kakubus/ISB_Project/README.md

<hr/>
<h5>Politechnika Śląska</br>
Wydział Automatyki Elektroniki i Informatyki</br>
Automatyka i Robotyka Sem V (2020/2021). Grupa TI-4 (s. 5)</h5>
<hr/>
<h2>Inteligentny sterownik bramy - <i>Projekt na Systemy Mikroprocesorowe</i></h2>
<b>Autorzy:</b><br/>
<ul>
   <li><i>Jakub Kaniowski (https://github.com/kakubus)</i></li>
   <li><i>Szymon Ciemała (https://github.com/szymciem8)</i></li>
</ul>
<hr/>

<h4>Struktura repozytorium:</h4>

1. <b>main</b> - Główny program sterownika</i>
    * W tym miejscu znajdują się główne pliki dot. kodów źródłowych projektu - kod do ESP (*.ino).
2. <b>multiplexerTools</b> - Program obsługi multipleksera</i>
    * W tym miejscu znajdują się przydatne pliki do obsługi multipleksera. Może się przydać na przyszłość (*.ino).
3. <b>motorTools</b> - Prosty program sterowania L293D</i>
    * W tym miejscu znajdują się przydatne pliki do obsługi L293D. Może się przydać na przyszłość (*.ino).
4. <b>Documentation</b> - <i>folder plików</i>
    * W tym miejscu, znajduje się cała dokumentacja projektu. 
        * <b>Raport końcowy wymagany do prezentacji projektu na zajęciach.</b>
        * Dokumentacja związana z elementami stosowanymi w projekcie.
        * Inne pliki tymczasowe, schematy elektryczne, projekty płytek PCB.
6. <b>RFID</b> - <i>Program testowy dla modułu RFID</i>
 </br></br>   
 <hr/>
<p align="center">
   <p>Zaprojektowana i wytrawiona płytka PCB:<br/></p>
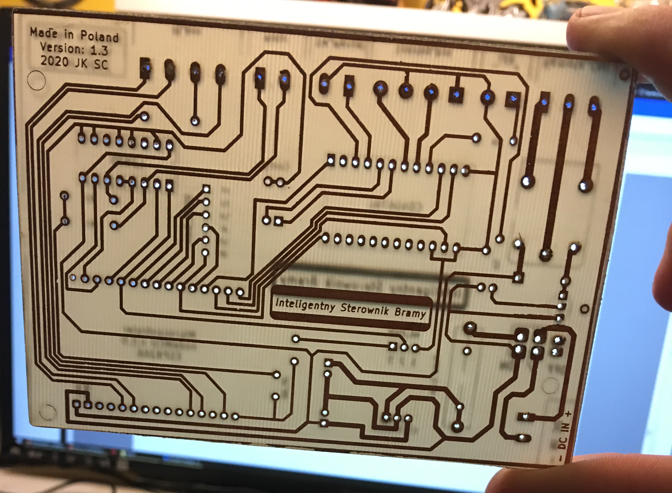
[picture p1: Inne/IMG_9818.JPG]
PCB
   
   <p>Skonstruowany sterownik:<br/></p>
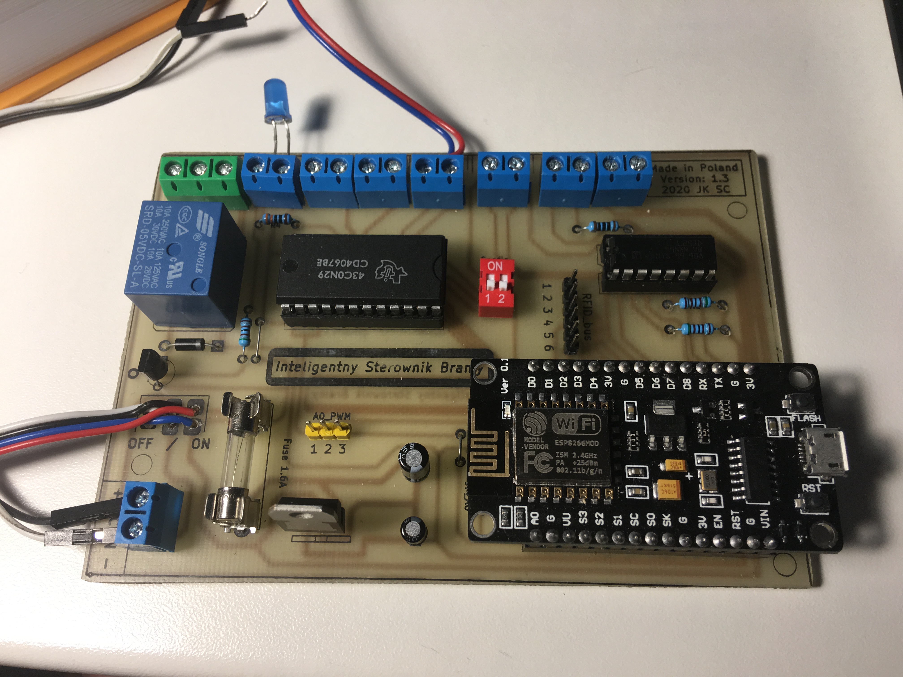
[picture p2: Inne/IMG_9850.JPG]
Sterownik bramy
   
   <p>Platforma testowa:<br/></p>
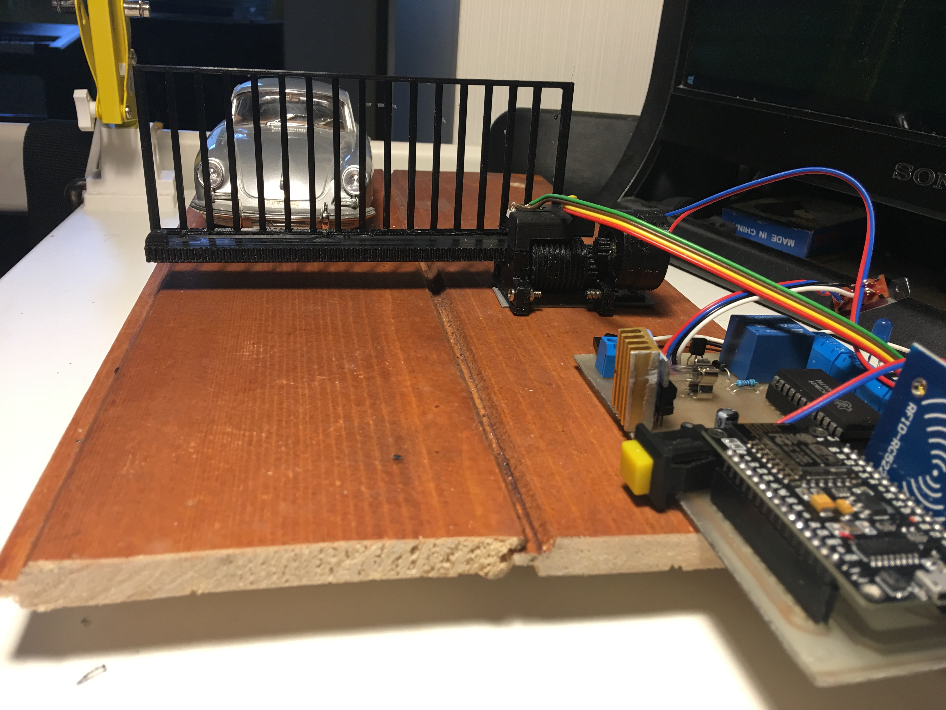
[picture p3: Inne/IMG_9793.JPG]
Platforma testowa
   
</p>
  <br/>
  <hr/>  
  <h6>Start projektu: Październik 2020 | Zakończenie: Grudzień 2020</h6>
  <hr/>
