kakubus/ISB_Project/Documentation/modelNapedu.png

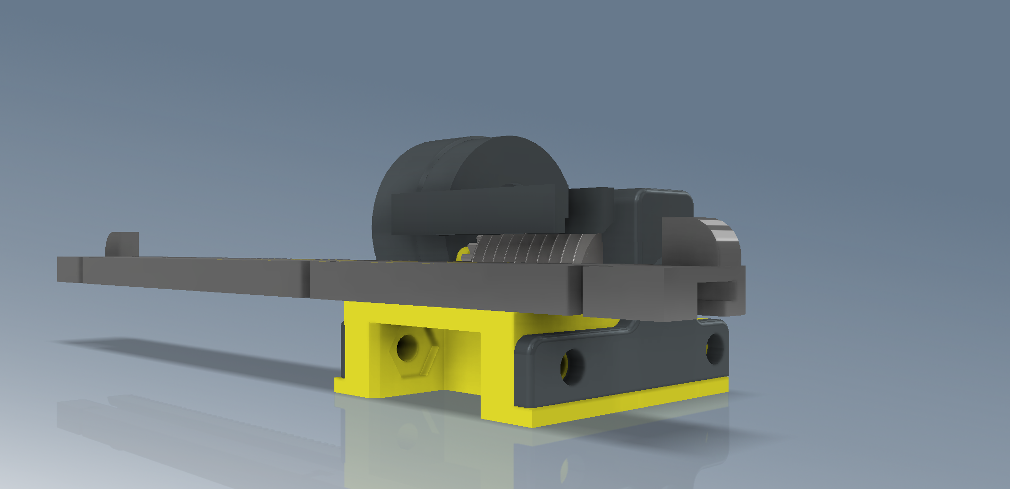
Documentation/modelNapedu.png
