kakubus/ISB_Project/Documentation/sterowanie przekaznikiem.png

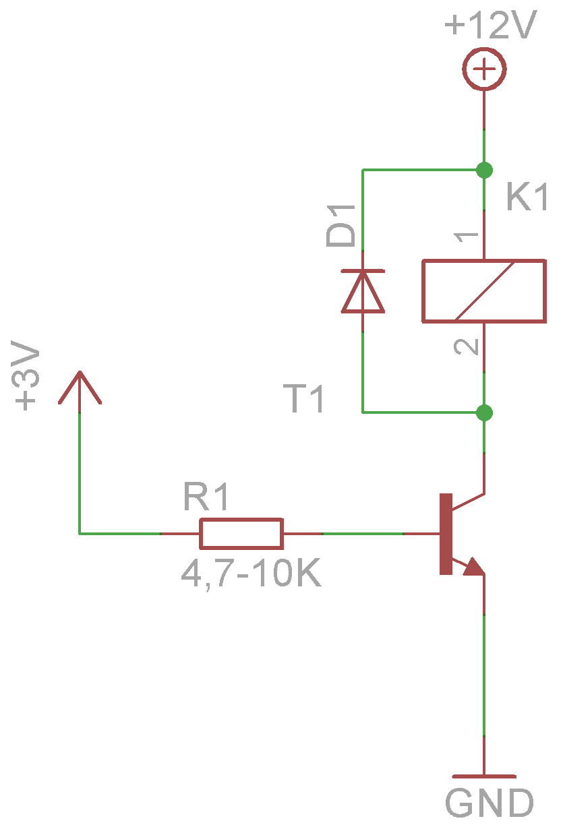
Documentation/sterowanie przekaznikiem.png
