kakubus/ISB_Project/Inne/IMG_9711.JPG

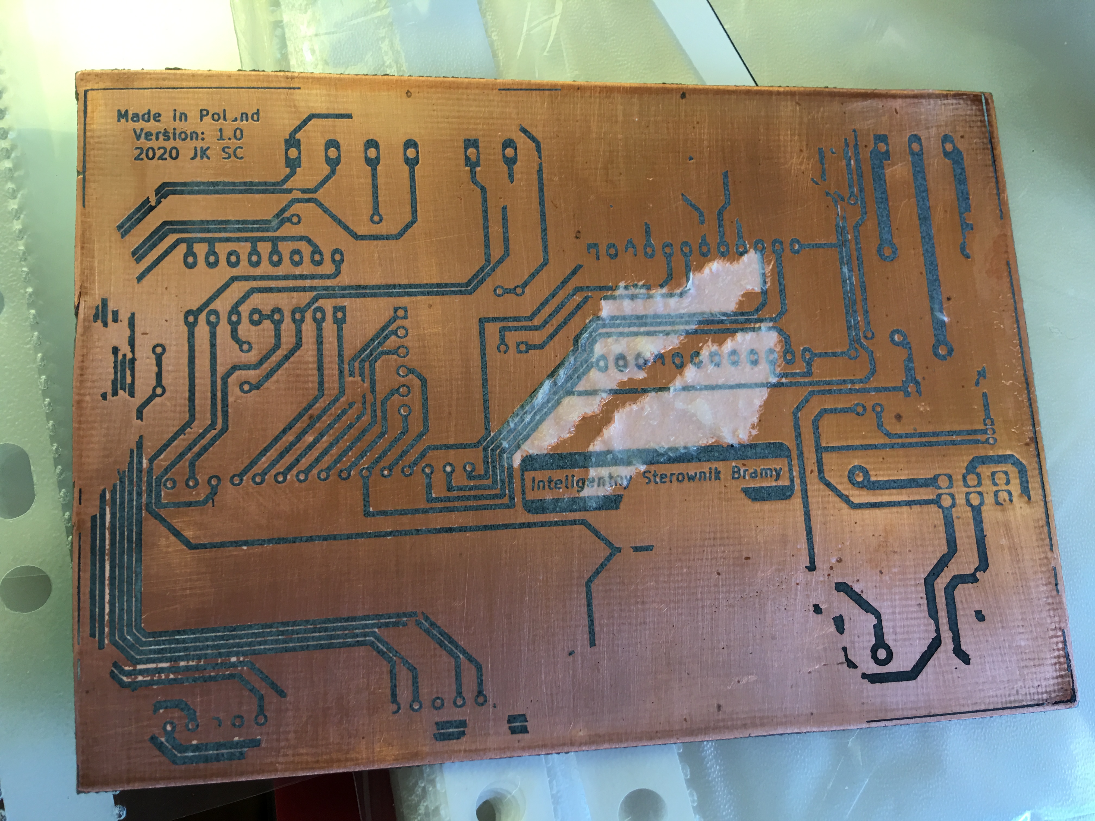
Inne/IMG_9711.JPG
