kakubus/ISB_Project/Inne/IMG_9712.JPG

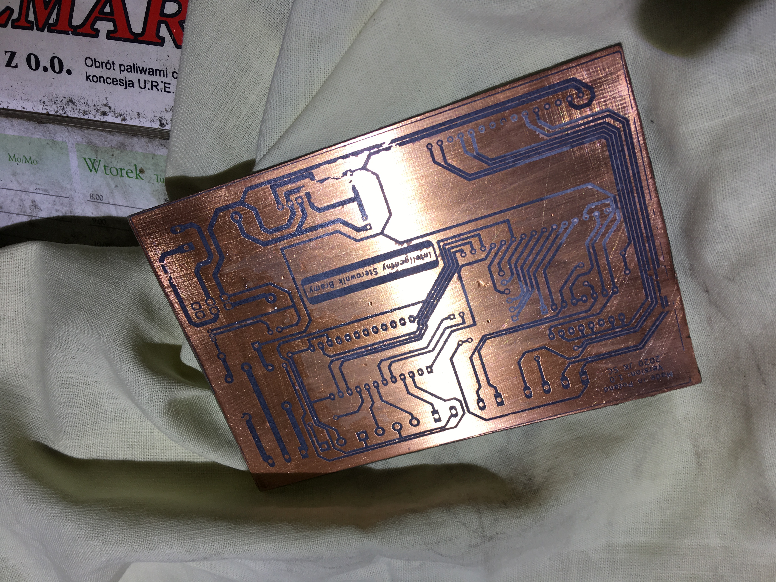
Inne/IMG_9712.JPG
