kakubus/ISB_Project/Inne/IMG_9717.JPG

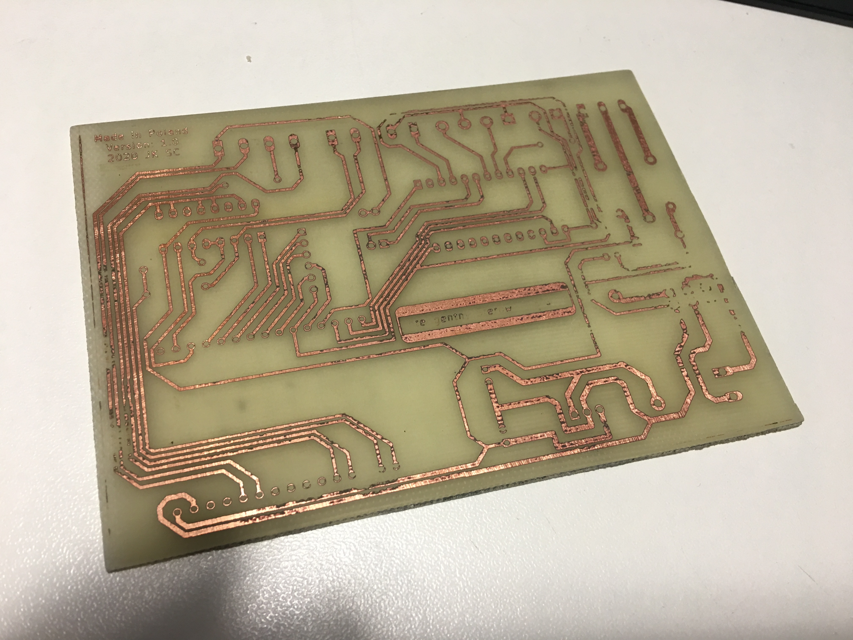
Inne/IMG_9717.JPG
