kakubus/ISB_Project/Inne/IMG_9733.JPG

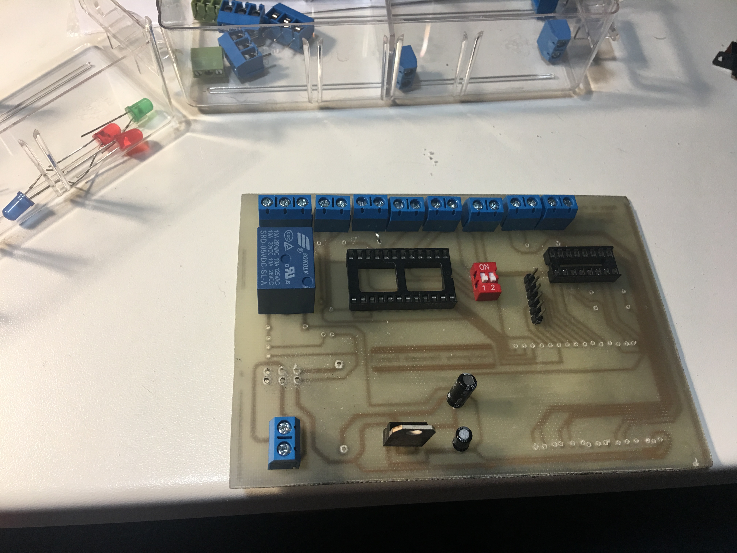
Inne/IMG_9733.JPG
