kakubus/ISB_Project/Inne/IMG_9734.JPG

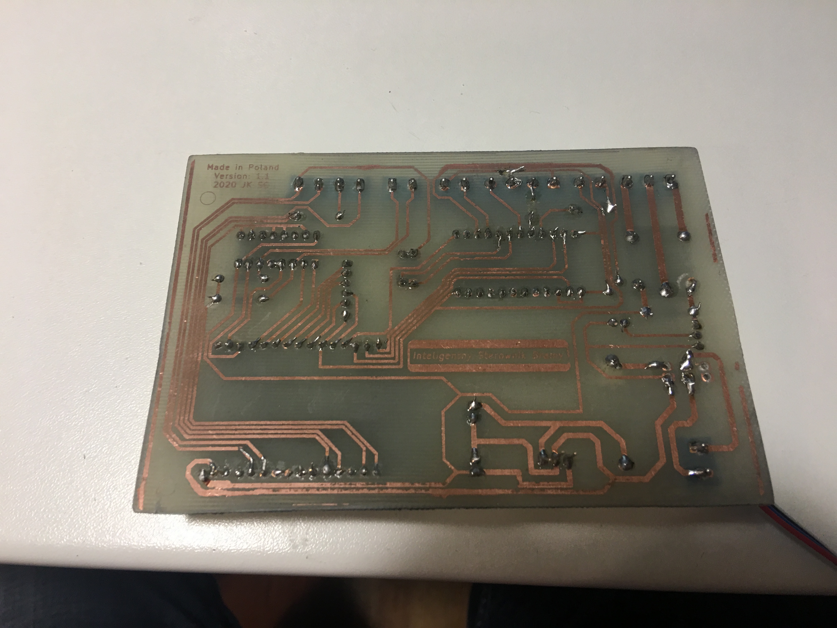
Inne/IMG_9734.JPG
