kakubus/ISB_Project/Inne/IMG_9735.JPG

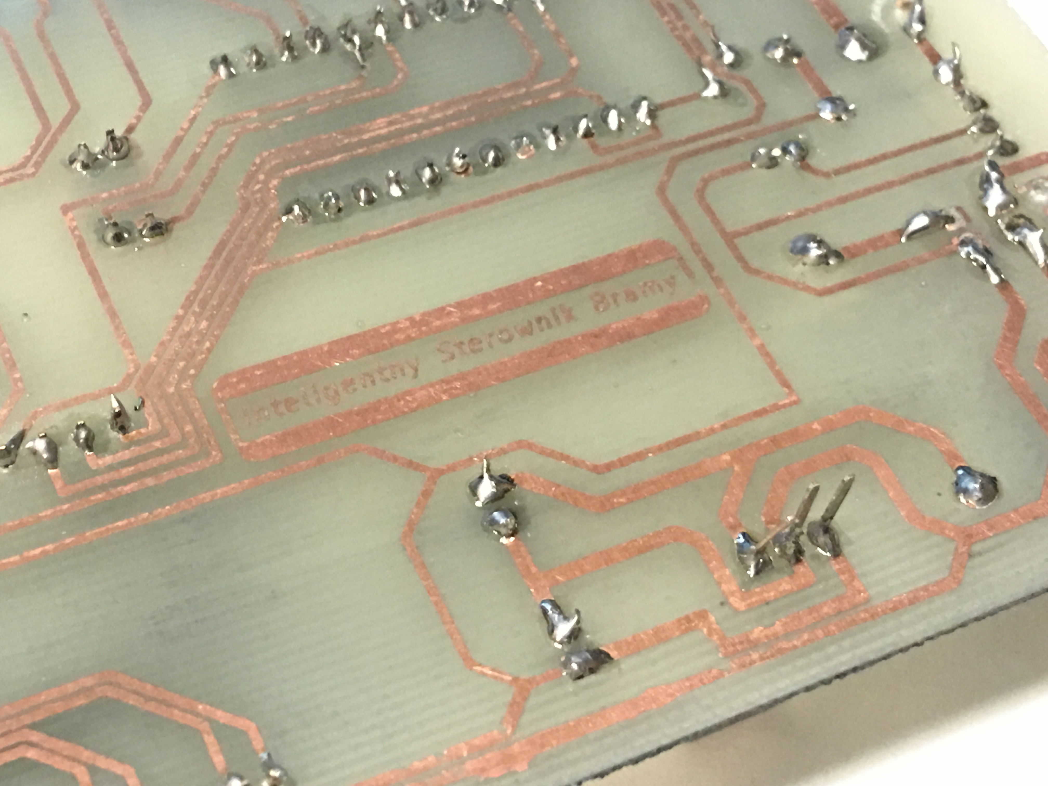
Inne/IMG_9735.JPG
