kakubus/ISB_Project/Inne/IMG_9736.JPG

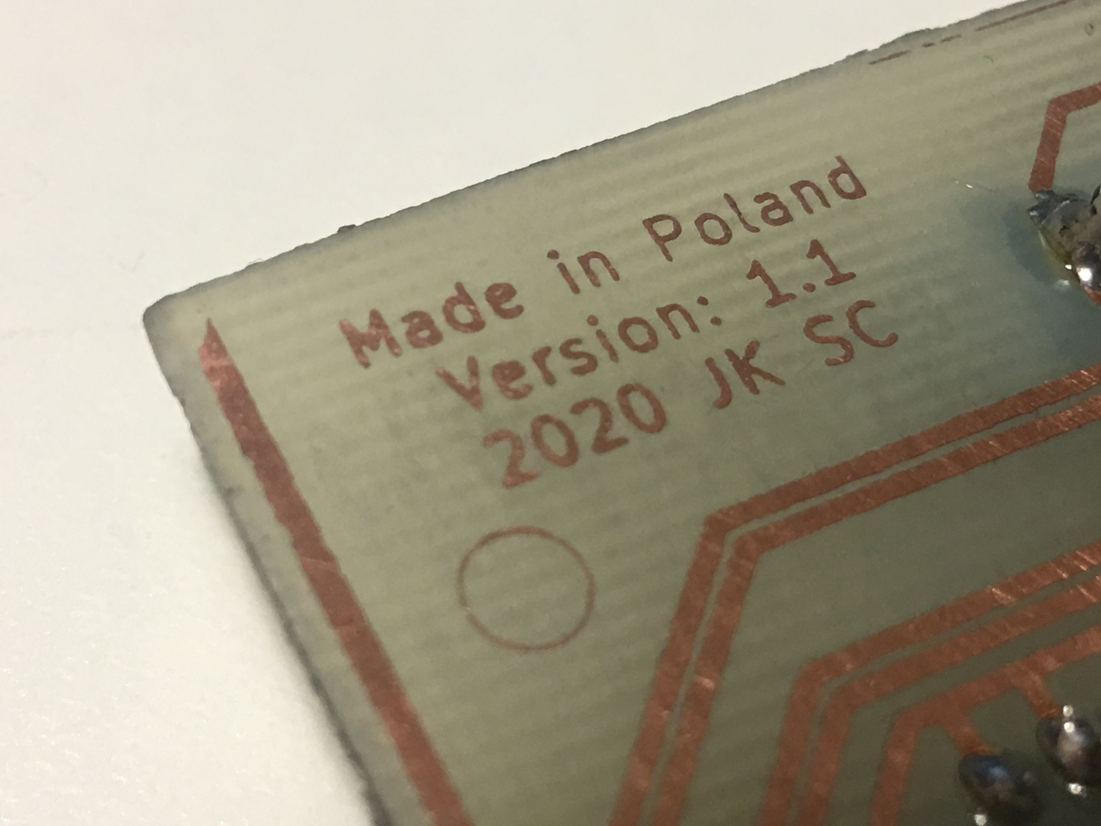
Inne/IMG_9736.JPG
