kakubus/ISB_Project/Inne/IMG_9737.JPG

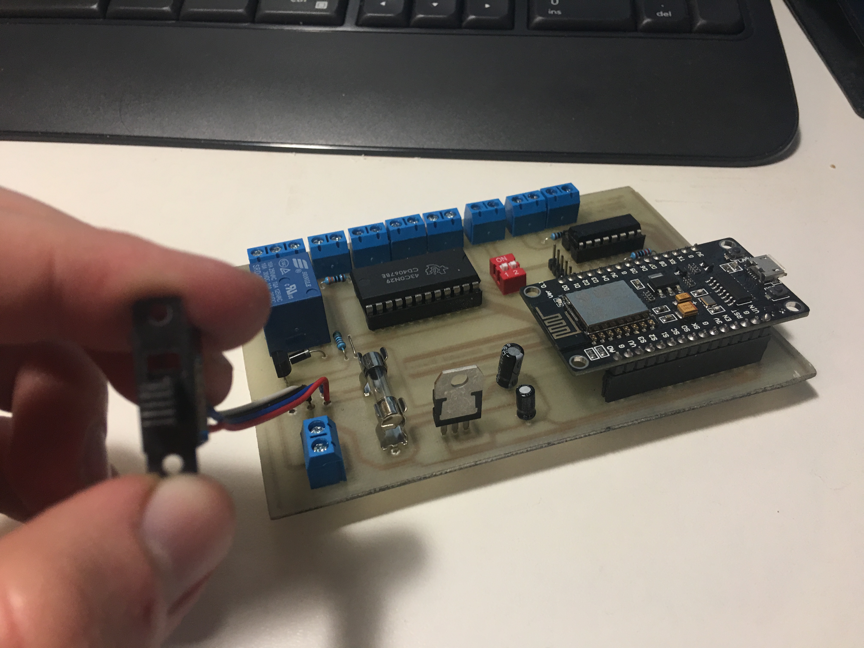
Inne/IMG_9737.JPG
