kakubus/ISB_Project/Inne/IMG_9738.JPG

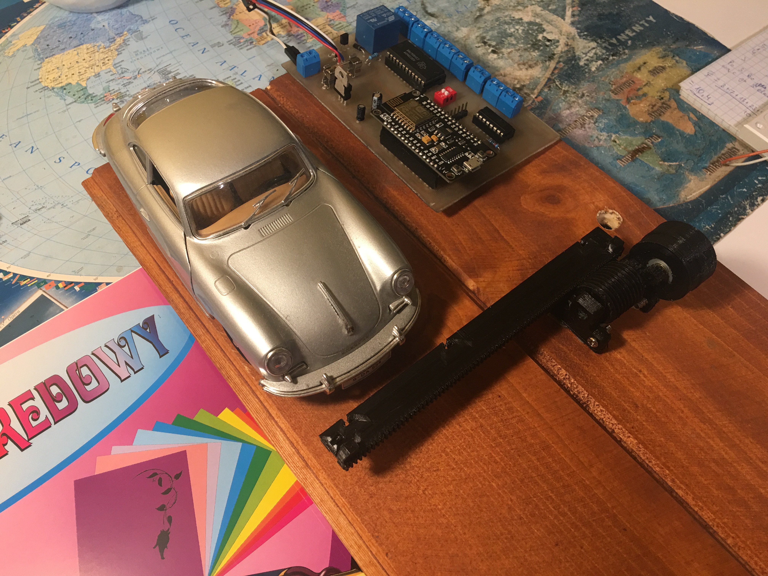
Inne/IMG_9738.JPG
