kakubus/ISB_Project/Inne/IMG_9743.JPG

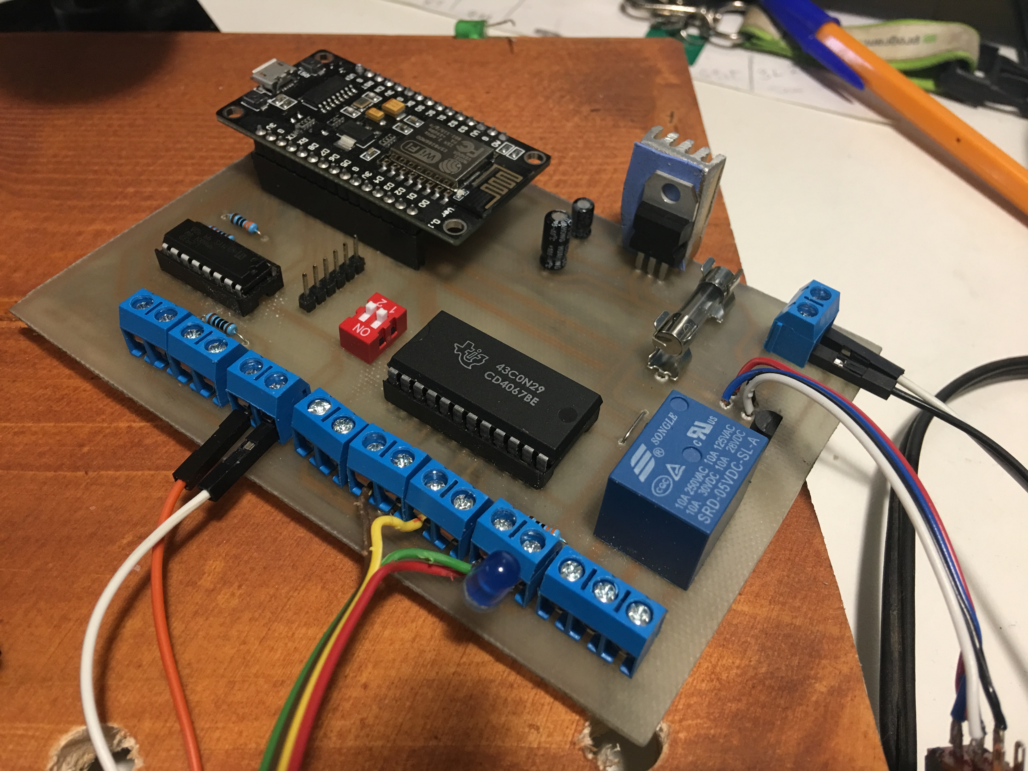
Inne/IMG_9743.JPG
