kakubus/ISB_Project/Inne/IMG_9752.JPG

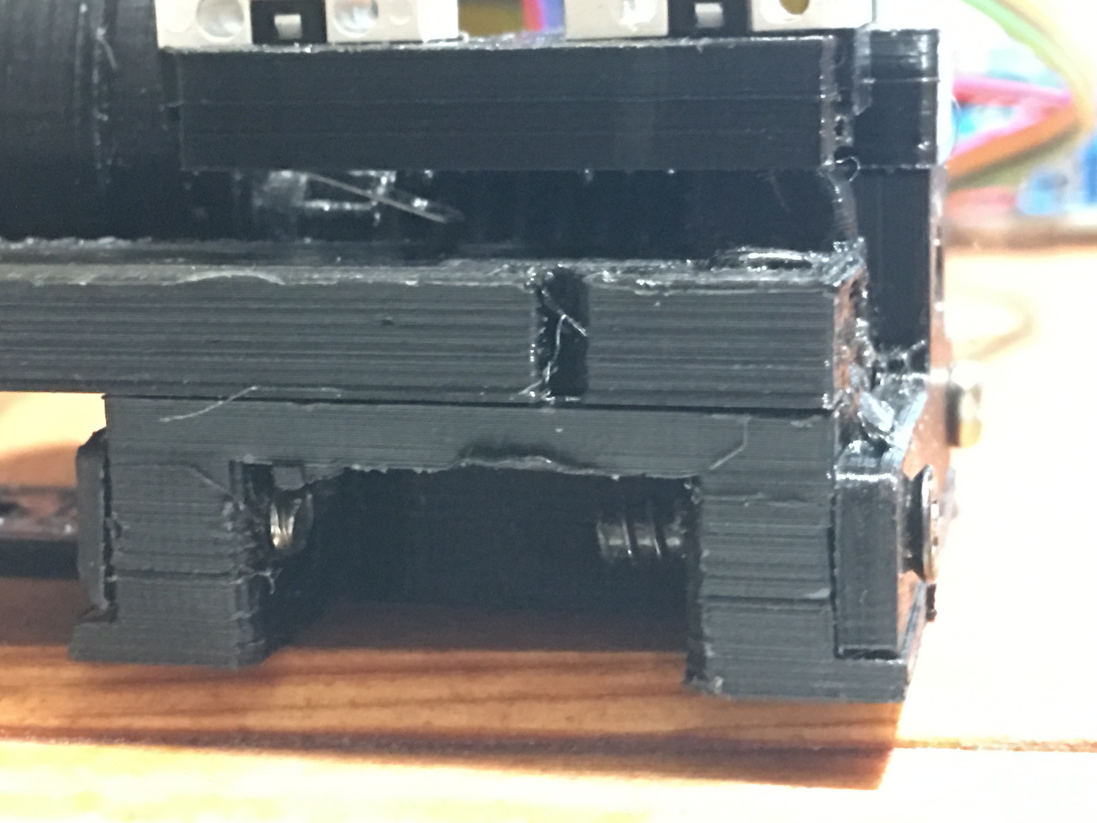
Inne/IMG_9752.JPG
