kakubus/ISB_Project/Inne/IMG_9763.JPG

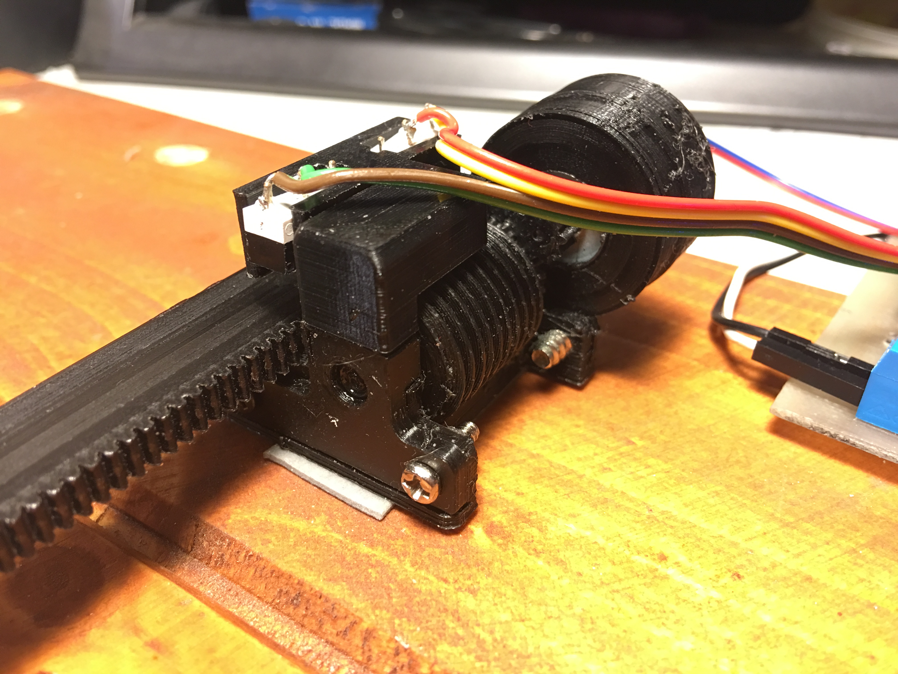
Inne/IMG_9763.JPG
