kakubus/ISB_Project/Inne/IMG_9764.JPG

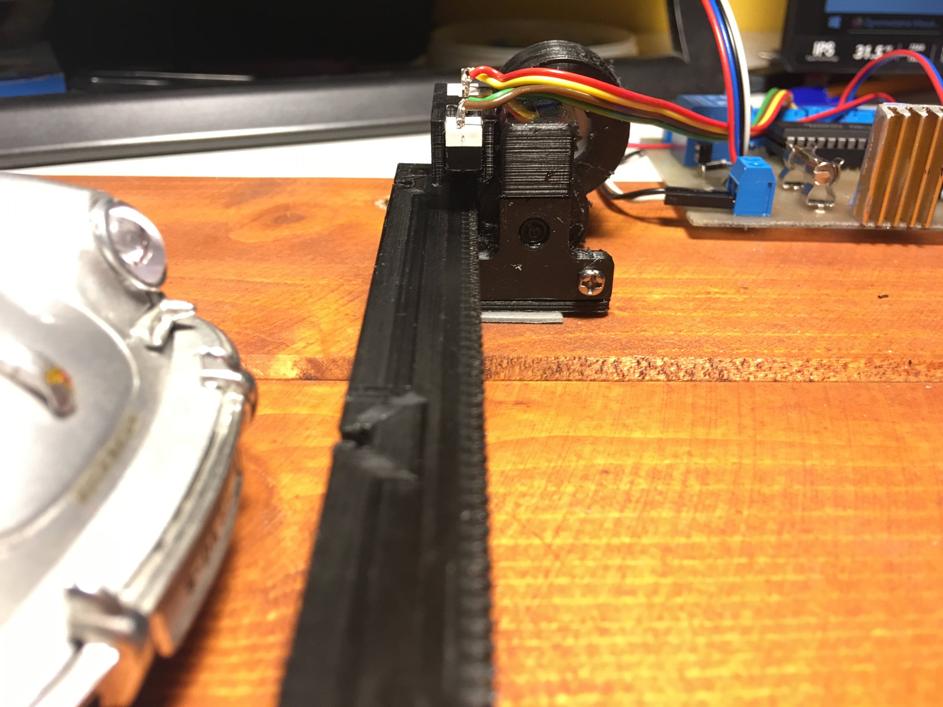
Inne/IMG_9764.JPG
