kakubus/ISB_Project/Inne/IMG_9765.JPG

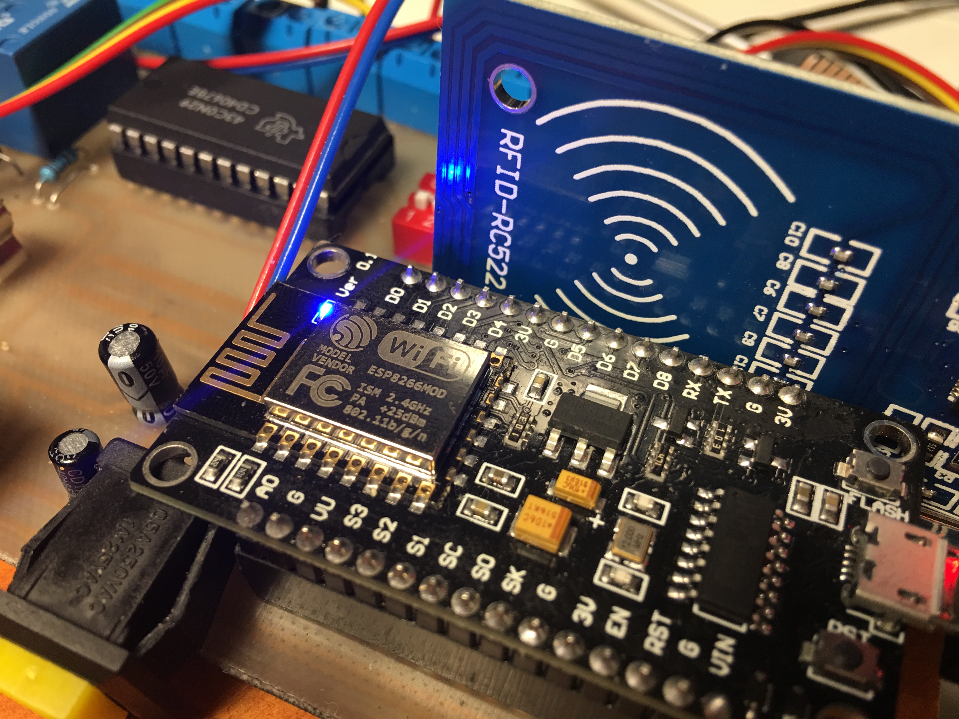
Inne/IMG_9765.JPG
