kakubus/ISB_Project/Inne/IMG_9766.JPG

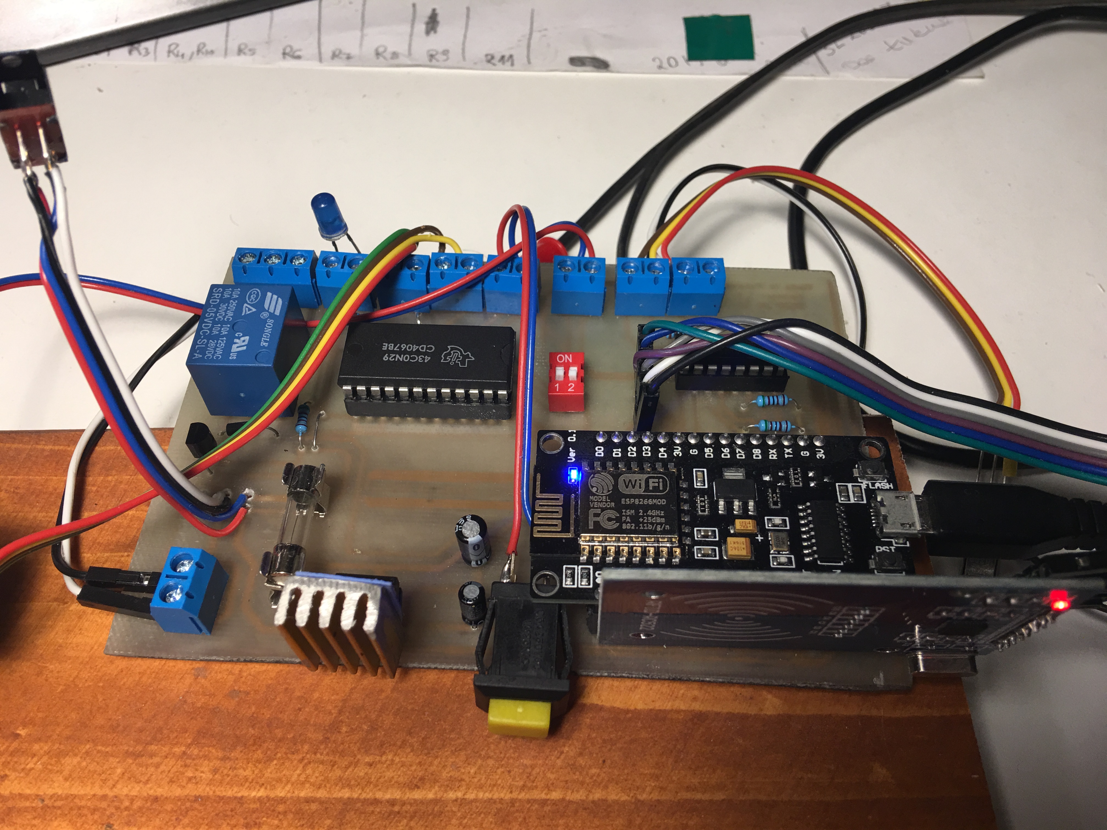
Inne/IMG_9766.JPG
