kakubus/ISB_Project/Inne/IMG_9768.JPG

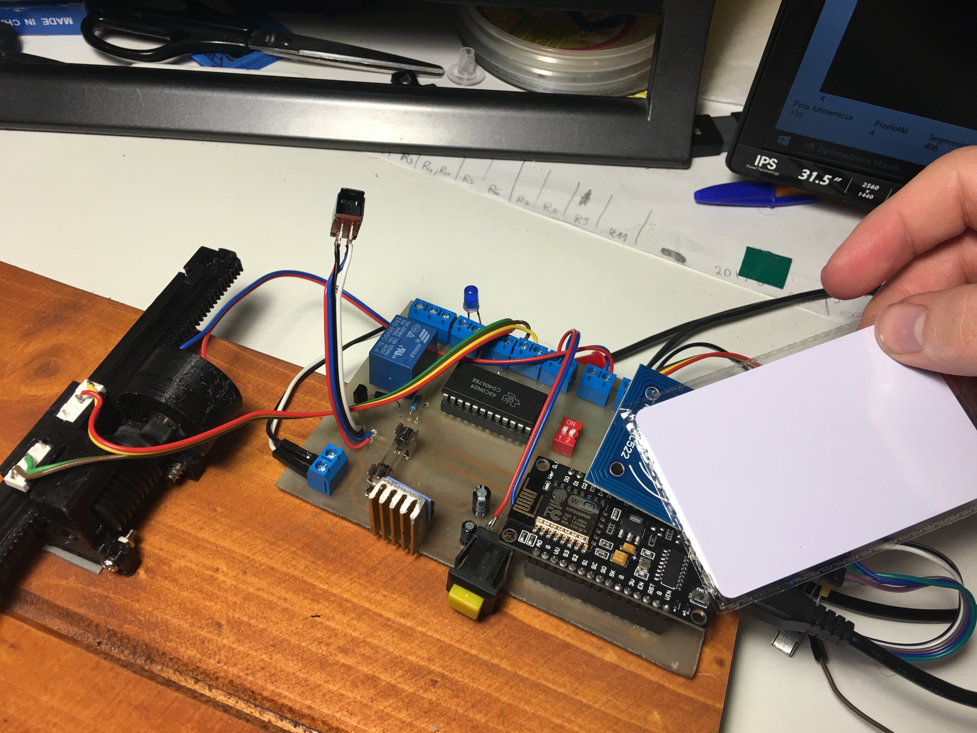
Inne/IMG_9768.JPG
