kakubus/ISB_Project/Inne/IMG_9770.JPG

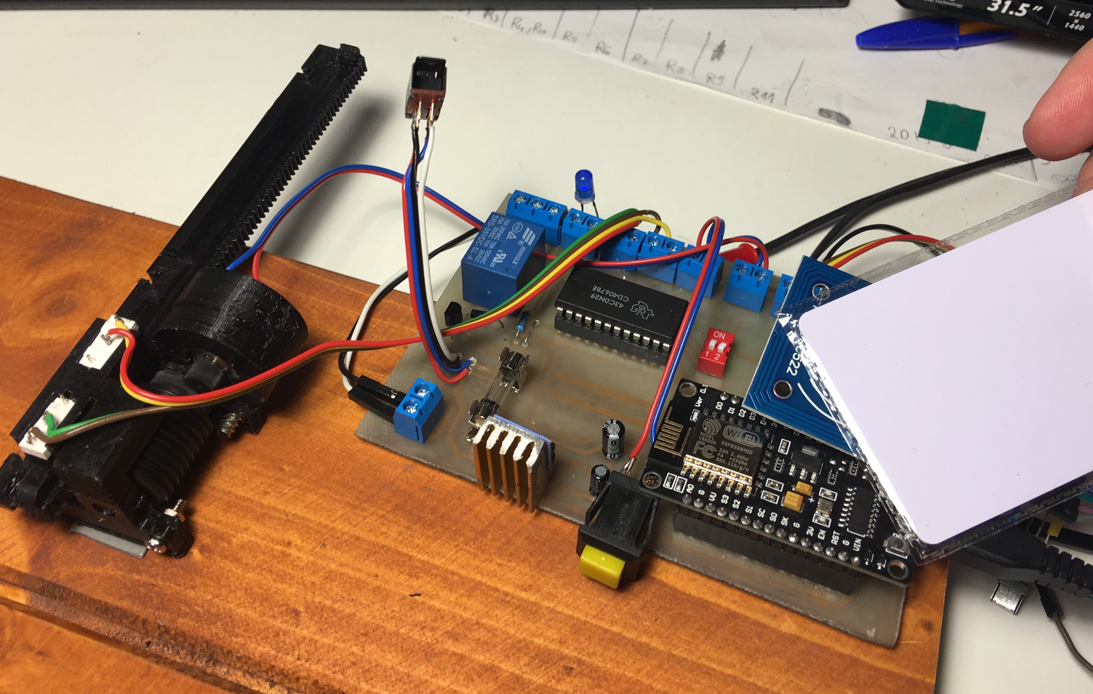
Inne/IMG_9770.JPG
