kakubus/ISB_Project/Inne/IMG_9774.JPG

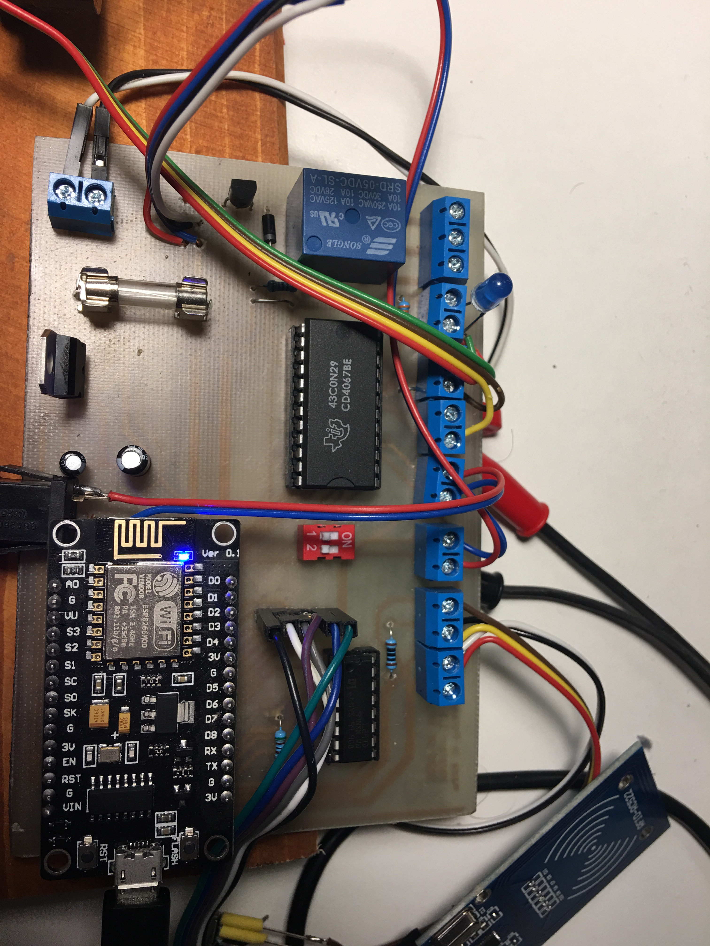
Inne/IMG_9774.JPG
