kakubus/ISB_Project/Inne/IMG_9775.PNG

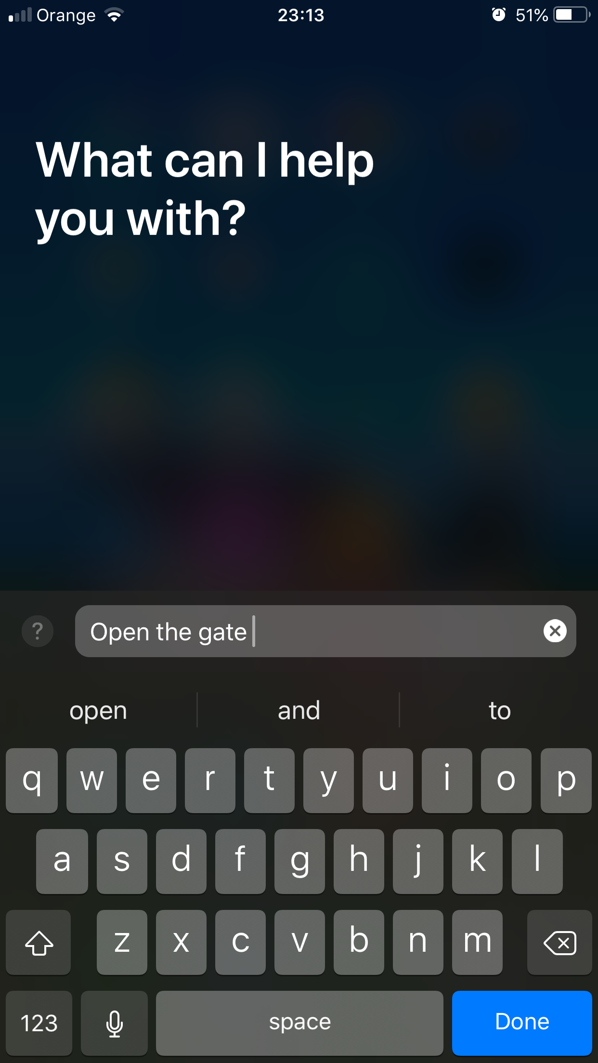
Inne/IMG_9775.PNG
