kakubus/ISB_Project/Inne/IMG_9777.JPG

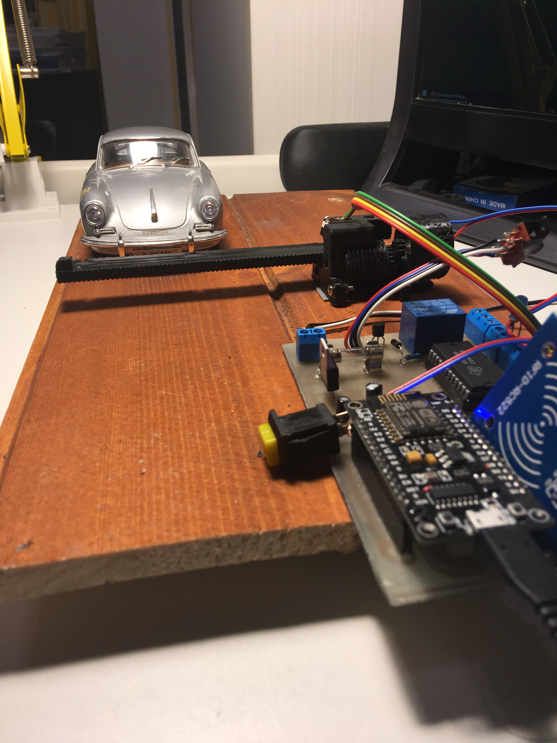
Inne/IMG_9777.JPG
