kakubus/ISB_Project/Inne/IMG_9778.PNG

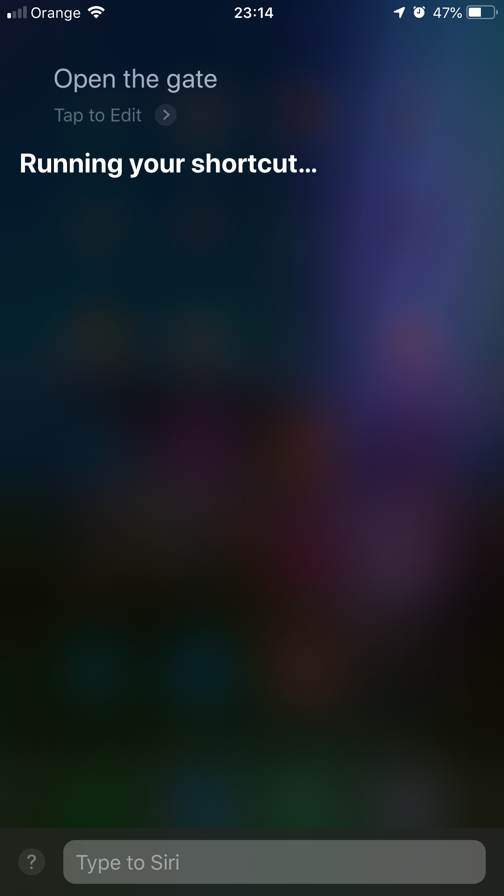
Inne/IMG_9778.PNG
