kakubus/ISB_Project/Inne/IMG_9780.JPG

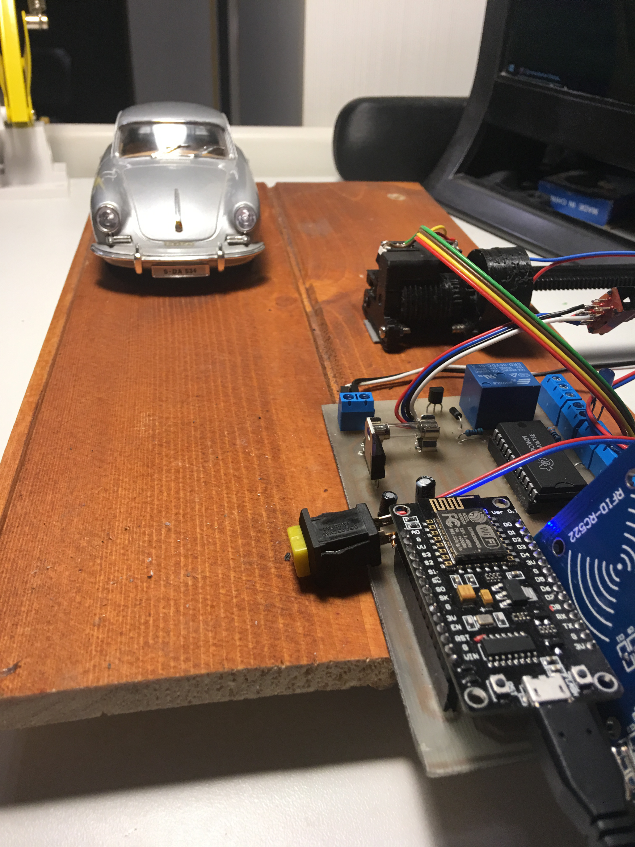
Inne/IMG_9780.JPG
