kakubus/ISB_Project/Inne/IMG_9782.PNG

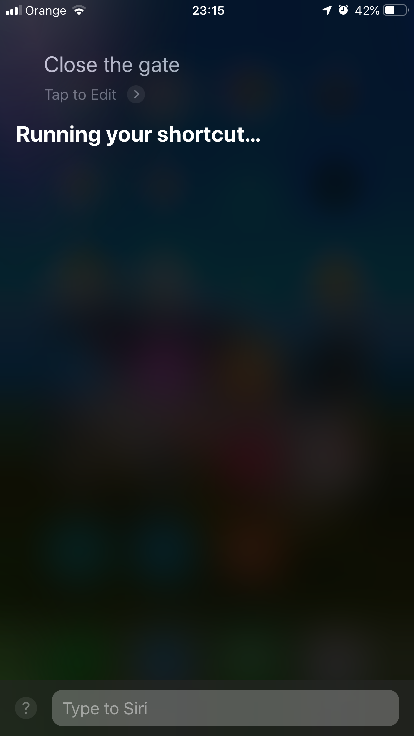
Inne/IMG_9782.PNG
