kakubus/ISB_Project/Inne/IMG_9783.JPG

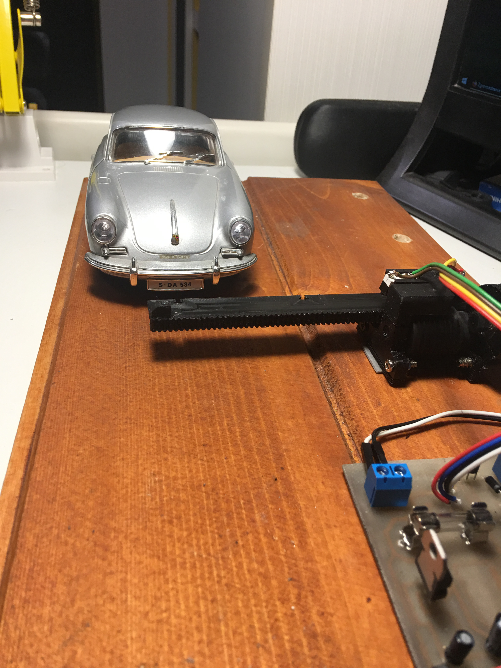
Inne/IMG_9783.JPG
