kakubus/ISB_Project/Inne/IMG_9790.JPG

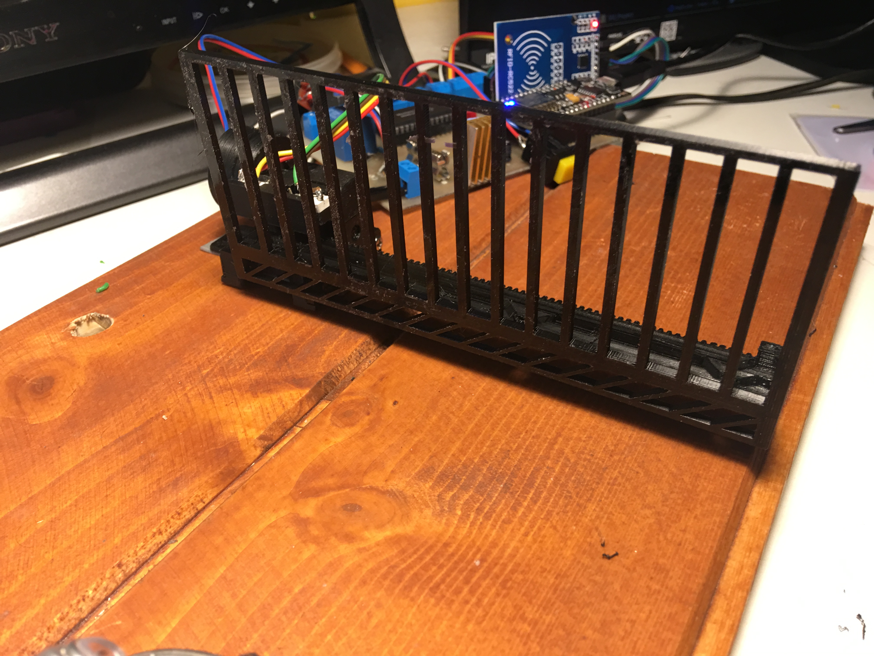
Inne/IMG_9790.JPG
