kakubus/ISB_Project/Inne/IMG_9791.JPG

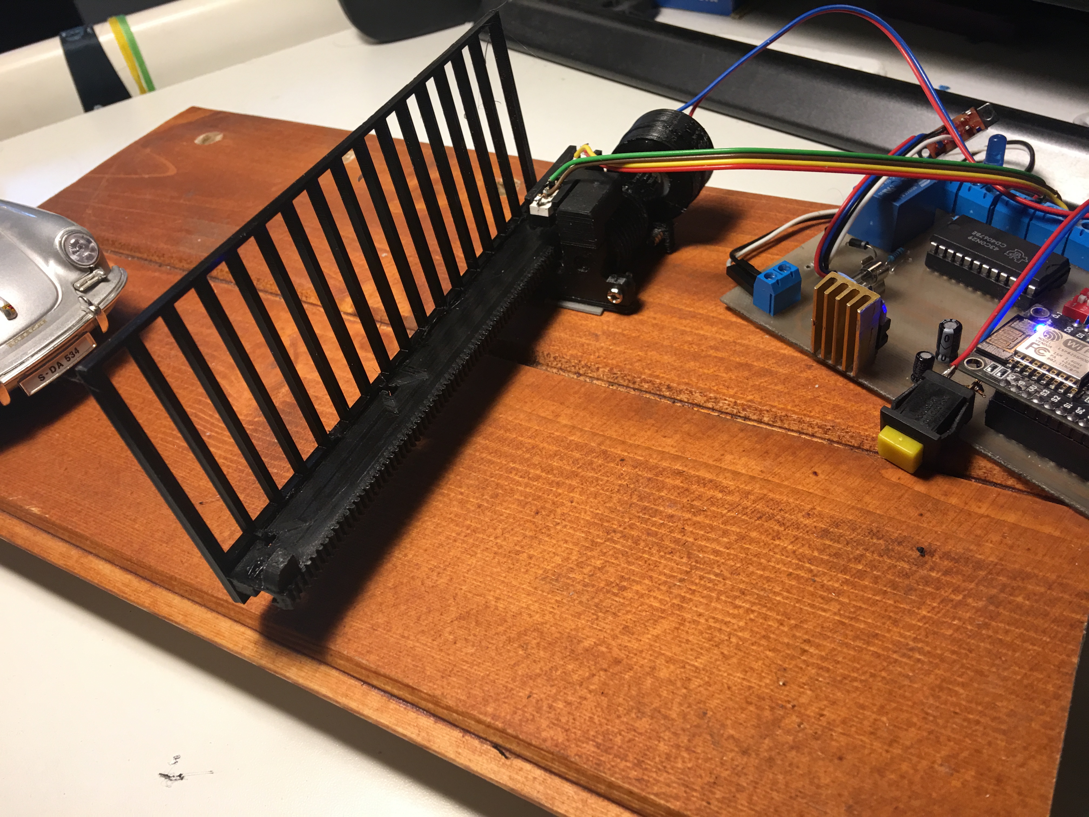
Inne/IMG_9791.JPG
