kakubus/ISB_Project/Inne/IMG_9792.JPG

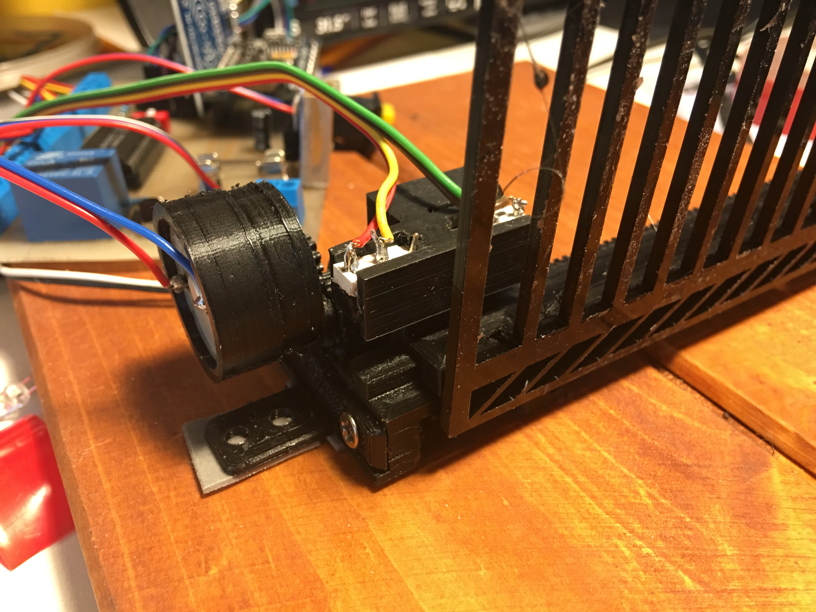
Inne/IMG_9792.JPG
