kakubus/ISB_Project/Inne/IMG_9794.JPG

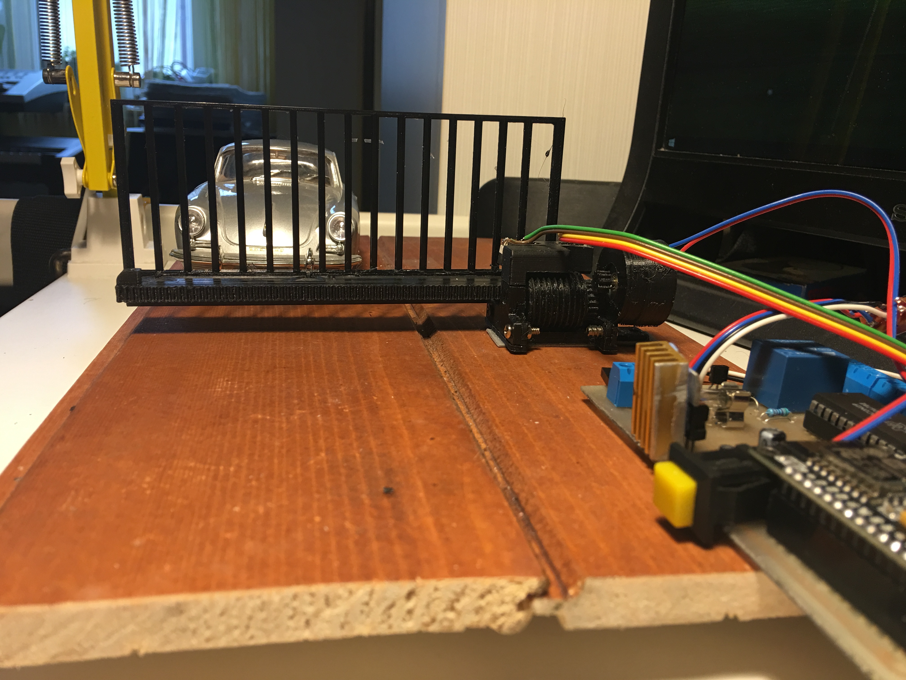
Inne/IMG_9794.JPG
