kakubus/ISB_Project/Inne/IMG_9840.JPG

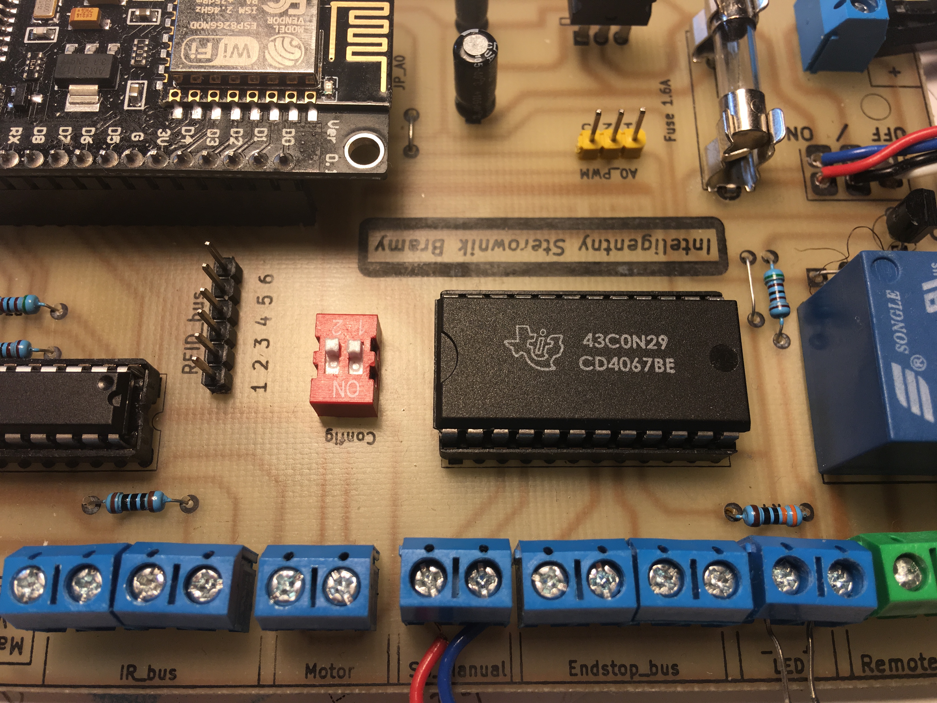
Inne/IMG_9840.JPG
