kakubus/ISB_Project/Inne/IMG_9841.JPG

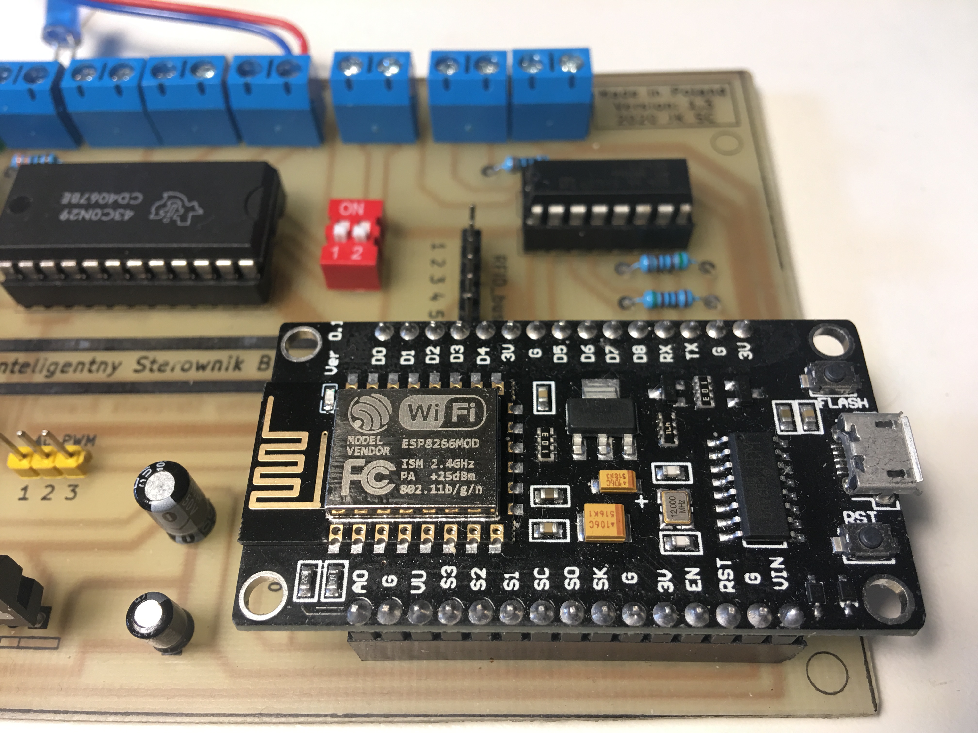
Inne/IMG_9841.JPG
