kakubus/ISB_Project/Inne/IMG_9849.jpg

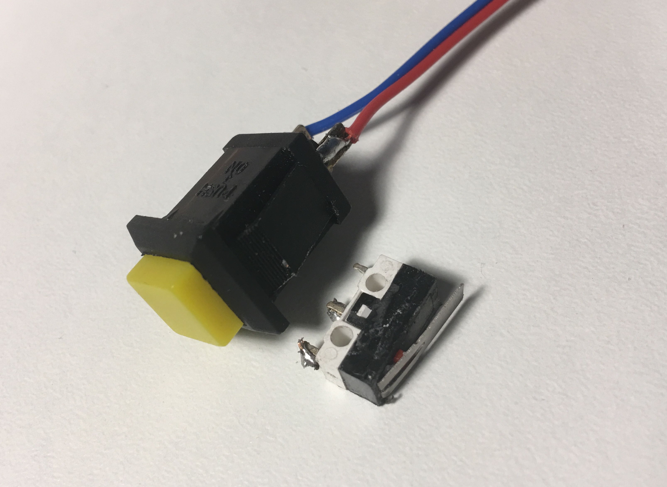
Inne/IMG_9849.jpg
