kakubus/ISB_Project/Documentation/Wykaz czesci.xlsx

Nazwa części | LINK | WIEDZA | PLNy
Sterownik Silnika L293D | https://botland.com.pl/pl/sterowniki-silnikow-dc/176-l293d-dwukanalowy-sterownik-silnikow-36v06a-5szt.html |  | 10 | 5
Odbiornik IR | https://botland.com.pl/pl/odbiorniki-podczerwieni/4931-odbiornik-podczerwieni-tsop31236-36-khz.html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 | https://forbot.pl/blog/kurs-elektroniki-ii-scalony-odbiornik-podczerwieni-tsop-id9641 | 3 | 1
Dioda IR | https://botland.com.pl/pl/diody-ir-podczerwone/282-nadajnik-ir-ope5594a-5mm-940nm.html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 |  |  | 1
Krańcówka | https://botland.com.pl/pl/przelaczniki-krancowe/17244-wylacznik-czujnik-krancowy-mini-5szt.html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
 | https://botland.com.pl/pl/czujniki-krancowe/10824-wylacznik-czujnik-krancowy-mini-z-dzwignia-wk611.html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 |  | 4
ESP8266 | https://botland.com.pl/pl/moduly-wifi/8241-modul-wifi-esp8266-nodemcu-v3.html?search_query=ESP8266&results=35 |  | 25 | 20
Diody LED | https://botland.com.pl/pl/diody-led/11440-dioda-led-5mm-czerwona-10szt.html?search_query=diody+LED&results=187 |  | 1.5
Przekaznik | https://botland.com.pl/pl/przekazniki-tradycyjne/4922-przekaznik-s3-5-cewka-5v-styki-10a240vac.html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 |  | 2
Elektro smieci R, C |  |  | 5
Bezpieczniki |  |  | 5
Silnik |  |  | 10
tactSwitch |  |  | 1.5
śrubki itp. |  |  | 5
RFID |  |  |  | 10
 |  |  | 72 | 37
