kakubus/ISB_Project/(list of files, drawings)

Other design files:
Documentation/PCB.pcb
