kakubus/ISB_Project/Documentation/PCB/Projekt/Projekt.kicad_pcb

## KiCad design Documentation/PCB/Projekt/Projekt.kicad_pcb (2022-06-17)

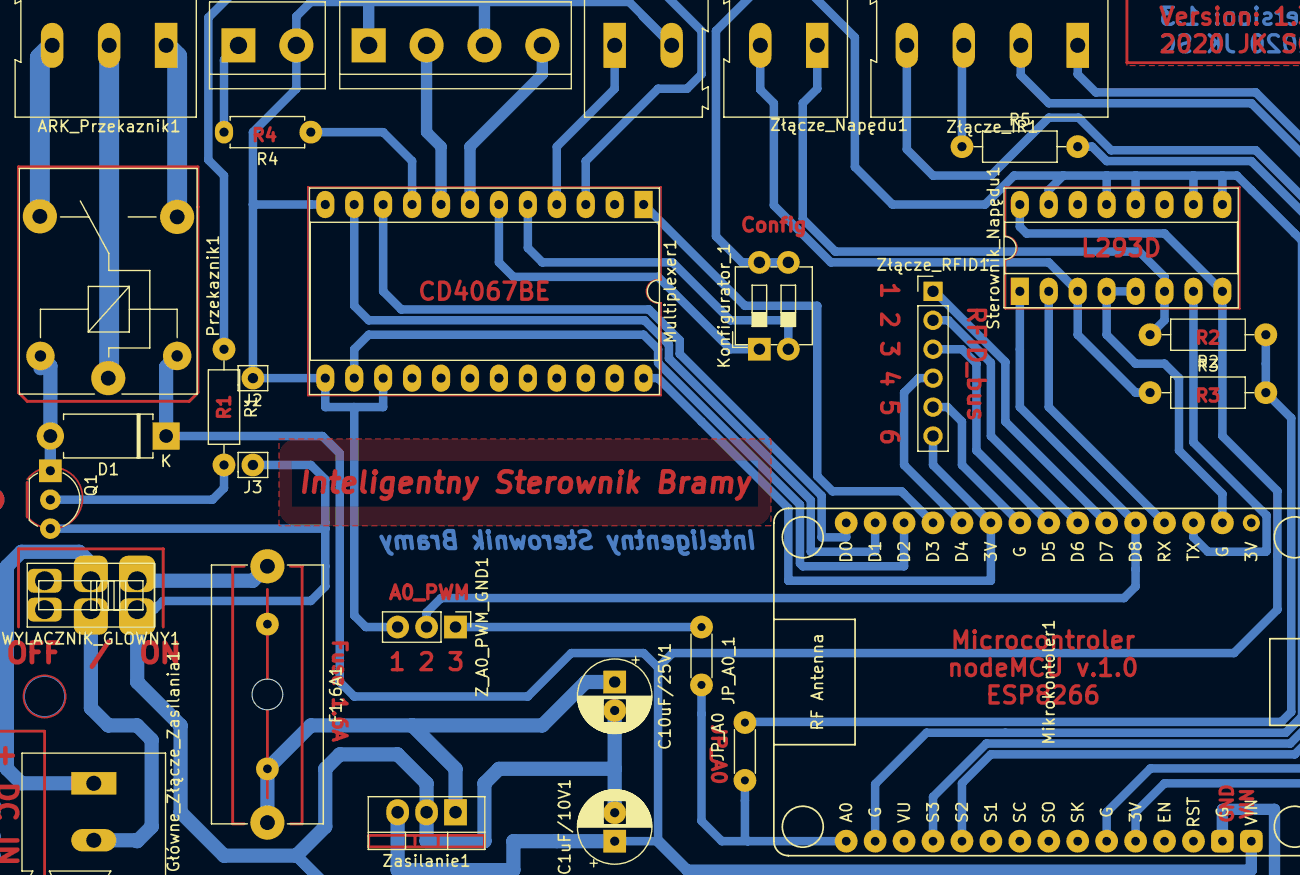
[picture p93: board Projekt.kicad_pcb from above]

Board: 2 copper layers, 30 parts (0 on the bottom side), 39 nets.

Parts:
ARK_Krancowki1: Conn_01x04_Female; TerminalBlock_bornier-4_P5.08mm
ARK_Powiad_LED1: Conn_01x02_Female; TerminalBlock_bornier-2_P5.08mm
ARK_Przekaznik1: Conn_01x03_Male; TerminalBlock_Altech_AK300-3_P5.00mm
C1uF/10V1, C10uF/25V1: CP1; CP_Radial_D6.3mm_P2.50mm
D1: D; D_DO-15_P10.16mm_Horizontal
F1,6A1: Fuse; MocownaieFuseholder_Cylinder-5x20mm_Schurter_0031_8201_Hori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
Główne_Złącze_Zasilania1: Conn_01x02_Female; TerminalBlock_Altech_AK300-2_P5.00mm
J2: Conn_01x01_Female; Pin_D0.9mm_L10.0mm_W2.4mm_FlatFork
J3: Conn_01x01_Male; Pin_D0.9mm_L10.0mm_W2.4mm_FlatFork
JP_A0, JP_A0_1: Jumper; R_Axial_DIN0204_L3.6mm_D1.6mm_P5.08mm_Horizontal
Konfigurator_1: SW_DIP_x02; SW_DIP_SPSTx02_Slide_6.7x6.64mm_W7.62mm_P2.54mm_LowProfile
Mikrokontoler1: NodeMCU1.0(ESP-12E); NodeMCU1.0(12-E)
Multiplexer1: CD4067BE; DIP-24_W15.24mm_Socket_LongPads
Przekaznik1: SANYOU_SRD_Form_C; Relay_SPDT_SANYOU_SRD_Series_Form_C
Q1: BC547; TO-92_Inline_Wide
R1: R5k; R_Axial_DIN0207_L6.3mm_D2.5mm_P10.16mm_Horizontal
R2: R220; R_Axial_DIN0207_L6.3mm_D2.5mm_P10.16mm_Horizontal
R3: R330; R_Axial_DIN0207_L6.3mm_D2.5mm_P10.16mm_Horizontal
R4: R330; R_Axial_DIN0207_L6.3mm_D2.5mm_P7.62mm_Horizontal
R5: R100; R_Axial_DIN0207_L6.3mm_D2.5mm_P10.16mm_Horizontal
Sterownik_Napędu1: L293D; DIP-16_W7.62mm_Socket_LongPads
WYLACZNIK_GLOWNY1: SW_DPST; SW_E_DPDT
Włącznik_Sterowania_Ręcznego1: SW_Push; TerminalBlock_Altech_AK300-2_P5.00mm
Z_A0_PWM_GND1: Zlacze_dev; PinHeader_1x03_P2.54mm_Vertical
Zasilanie1: LM7805_TO220; TO-220-3_Vertical
Złącze_IR1: 01; TerminalBlock_Altech_AK300-4_P5.00mm
Złącze_Napędu1: Conn_01x02_Female; TerminalBlock_Altech_AK300-2_P5.00mm
Złącze_RFID1: Conn_01x06_Female; PinHeader_1x06_P2.54mm_Vertical

Connections:
+12V: Główne_Złącze_Zasilania1.1, WYLACZNIK_GLOWNY1.3
/+3V: Mikrokontoler1.16, Mikrokontoler1.25, Multiplexer1.24, Złącze_RFID1.6
/+5V: C1uF/10V1.1, D1.1, Mikrokontoler1.15, Przekaznik1.2, Sterownik_Napędu1.8, Sterownik_Napędu1.16, Zasilanie1.3
/A0: JP_A0.1, JP_A0.2, JP_A0_1.2, Mikrokontoler1.1, R2.1, R3.2
/IR_emitter: Mikrokontoler1.4, R5.2
/IR_receiver: Mikrokontoler1.5, Złącze_IR1.4
/MUX_3Pin: Multiplexer1.3, R1.1
/PWM_mDC: Mikrokontoler1.20, Sterownik_Napędu1.1, Z_A0_PWM_GND1.2
GND: ARK_Krancowki1.1, ARK_Krancowki1.3, ARK_Powiad_LED1.2, C1uF/10V1.2, C10uF/25V1.2, Główne_Złącze_Zasilania1.2, J2.1, J3.1, Konfigurator_1.3, Konfigurator_1.4, Mikrokontoler1.14, Mikrokontoler1.17, Mikrokontoler1.24, Multiplexer1.12, Multiplexer1.13, Multiplexer1.15, Q1.3, Sterownik_Napędu1.4, Sterownik_Napędu1.5, Sterownik_Napędu1.9, Sterownik_Napędu1.10, Sterownik_Napędu1.12, Sterownik_Napędu1.13, Sterownik_Napędu1.15, WYLACZNIK_GLOWNY1.1, WYLACZNIK_GLOWNY1.2, Włącznik_Sterowania_Ręcznego1.2, Z_A0_PWM_GND1.3, Zasilanie1.2, Złącze_RFID1.5
unnamed: ARK_Krancowki1.2, Multiplexer1.8
unnamed: ARK_Krancowki1.4, Multiplexer1.7
unnamed: ARK_Powiad_LED1.1, R4.2
unnamed: ARK_Przekaznik1.1, Przekaznik1.3
unnamed: ARK_Przekaznik1.2, Przekaznik1.1
unnamed: ARK_Przekaznik1.3, Przekaznik1.4
unnamed: C10uF/25V1.1, F1,6A1.2, Zasilanie1.1
unnamed: D1.2, Przekaznik1.5, Q1.1
unnamed: F1,6A1.1, WYLACZNIK_GLOWNY1.4
unnamed: JP_A0_1.1, Z_A0_PWM_GND1.1
unnamed: Konfigurator_1.1, Multiplexer1.6
unnamed: Konfigurator_1.2, Multiplexer1.5
unnamed: Mikrokontoler1.10, Złącze_IR1.2
unnamed: Mikrokontoler1.11, Złącze_IR1.1
unnamed: Mikrokontoler1.18, Sterownik_Napędu1.7
unnamed: Mikrokontoler1.19, Sterownik_Napędu1.2
unnamed: Mikrokontoler1.21, Złącze_RFID1.1
unnamed: Mikrokontoler1.22, Złącze_RFID1.2
unnamed: Mikrokontoler1.23, Złącze_RFID1.3
unnamed: Mikrokontoler1.26, Złącze_RFID1.4
unnamed: Mikrokontoler1.27, Multiplexer1.1
unnamed: Mikrokontoler1.28, Multiplexer1.14
unnamed: Mikrokontoler1.29, Multiplexer1.11
unnamed: Mikrokontoler1.30, Multiplexer1.10
unnamed: Multiplexer1.4, Włącznik_Sterowania_Ręcznego1.1
unnamed: Multiplexer1.9, R4.1
unnamed: Q1.2, R1.2
unnamed: R2.2, Sterownik_Napędu1.6, Złącze_Napędu1.1
unnamed: R3.1, Sterownik_Napędu1.3, Złącze_Napędu1.2
unnamed: R5.1, Złącze_IR1.3
