kakubus/ISB_Project/Inne/IMG_9823.JPG

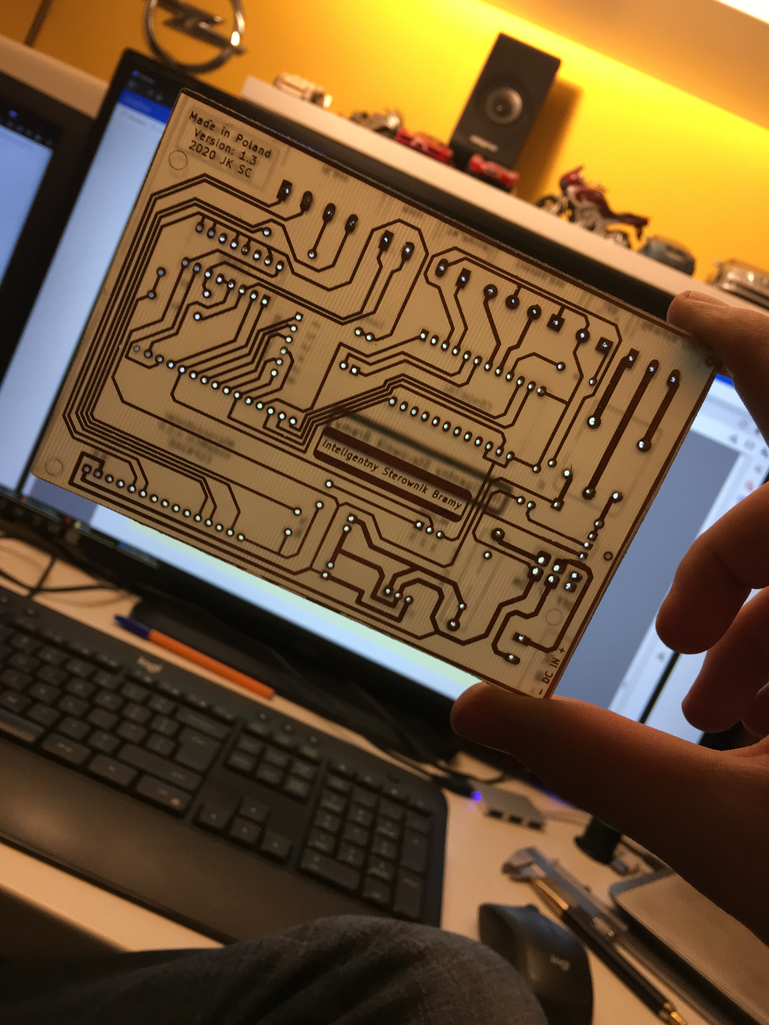
Inne/IMG_9823.JPG
